technoroad/TR_DCDC_Module/README.md

# TR_DCDC_Module
TR製DCDCモジュール（ストロベリーリナックス製LT3790モジュールの代替品）
