technoroad/TR_DCDC_Module/TR_i3_6A_Module_v11/readme.txt

---------------------------------------------------------------

RS-274X File List

---------------------------------------------------------------
* Outline		TR_i3_6A_Module_v11.out
* Top Side		TR_i3_6A_Module_v11.cmp
* Bottom Side		TR_i3_6A_Module_v11.sol

* Top Silkscreen	TR_i3_6A_Module_v11.plc
* Bottom Silkscreen	TR_i3_6A_Module_v11.pls

* Top Soldermask	TR_i3_6A_Module_v11.stc
* Bottom Soldermask	TR_i3_6A_Module_v11.sts

* Top Metal Mask	TR_i3_6A_Module_v11.mmc
* Bottom Metal Mask	TR_i3_6A_Module_v11.mms

* Drill List		TR_i3_6A_Module_v11.drl
* Drill Data1		TR_i3_6A_Module_v11.drd
* Drill Data2		TR_i3_6A_Module_v11.dri

---------------------------------------------------------------
