technoroad/TR_DCDC_Module/TR_i3_6A_Module_v10/TR_i3_6A_Module_v10_ガーバー/readme.txt

---------------------------------------------------------------

RS-274X File List

---------------------------------------------------------------
* Outline		TR_i3_6A_Module_v10.out
* Top Side		TR_i3_6A_Module_v10.cmp
* Bottom Side		TR_i3_6A_Module_v10.sol

* Top Silkscreen	TR_i3_6A_Module_v10.plc
* Bottom Silkscreen	TR_i3_6A_Module_v10.pls

* Top Soldermask	TR_i3_6A_Module_v10.stc
* Bottom Soldermask	TR_i3_6A_Module_v10.sts

* Top Metal Mask	TR_i3_6A_Module_v10.mmc
* Bottom Metal Mask	TR_i3_6A_Module_v10.mms

* Drill List		TR_i3_6A_Module_v10.drl
* Drill Data1		TR_i3_6A_Module_v10.drd
* Drill Data2		TR_i3_6A_Module_v10.dri

---------------------------------------------------------------
