technoroad/TR_DCDC_Module/TR_i3_6A_Module_v5/ガーバー/readme.txt

---------------------------------------------------------------

RS-274X File List

---------------------------------------------------------------
* Outline		TR_i3_6A_Module_v5.out
* Top Side		TR_i3_6A_Module_v5.cmp
* Bottom Side		TR_i3_6A_Module_v5.sol

* Top Silkscreen	TR_i3_6A_Module_v5.plc
* Bottom Silkscreen	TR_i3_6A_Module_v5.pls

* Top Soldermask	TR_i3_6A_Module_v5.stc
* Bottom Soldermask	TR_i3_6A_Module_v5.sts

* Top Metal Mask	TR_i3_6A_Module_v5.mmc
* Bottom Metal Mask	TR_i3_6A_Module_v5.mms

* Drill List		TR_i3_6A_Module_v5.drl
* Drill Data		TR_i3_6A_Module_v5.drd

---------------------------------------------------------------
