technoroad/TR_DCDC_Module/TR_i3_6A_Module_v11/レジスト開口.png

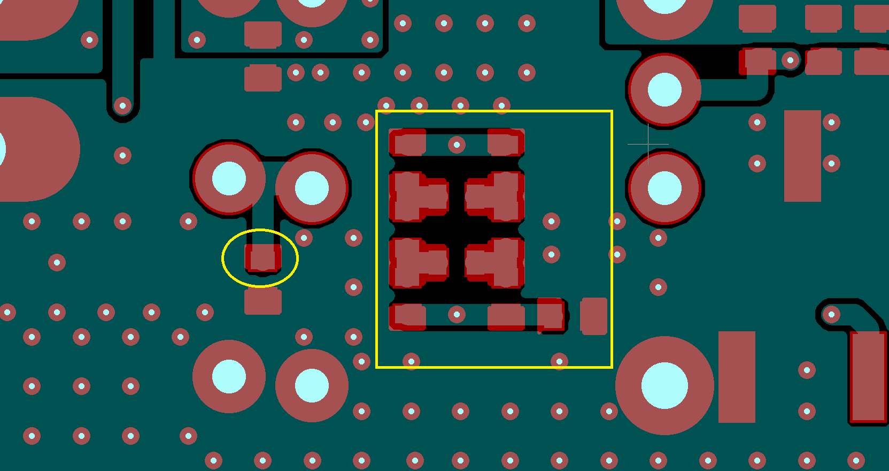
TR_i3_6A_Module_v11/レジスト開口.png
