technoroad/TR_DCDC_Module/TR_i3_6A_Module_部品リスト(TR製DCDCモジュール).xlsx

更新
2022-12-20
基板製造数
10 |  |  | TR製DCDCモジュール （ロボット電源）基板用_部品リスト
実装数
10
部品名 | シルク | 値 | 型番 | サイズ パッケージ | メーカー | 1基板 必要数 | 製造 必要 | 備考 | 購入先 | 最小購入数 または必要数 | 部品単価 | 小計 | URL | 基板単価 計算用
コンデンサ | C1, C2 | 0.1uF_100V | CS0603KRX7R0BB104 | 1.6 x 0.8 | Yageo | 2 | 20 |  | RS | 100 | 11.43 | 1143 | https://jp.rs-online.com/web/p/mlccs-multilayer-ceramic-capacitors/1988188 | 22.86
 | C3 | 1000pF_100V | GRM1882C2A102JA01D | 1.6 x 0.8 | Murata | 1 | 10 |  | RS | 100 | 3.98 | 398 | https://jp.rs-online.com/web/p/mlccs-multilayer-ceramic-capacitors/7984618 | 3.98
 | CC1, CC2 | 220uF_100V | 100PX220MEFC12.5X20 | 12.5 x 20 | Rubycon | 2 | 20 |  | Digikey | 50 | 106.42 | 5321 | https://www.digikey.jp/short/pvm9wfnq | 212.84
抵抗 | R1 | 別途 | 別途 | 1.6 x 0.8 | 別途 | 1 | 10 | 別途 | RS | 100 | 0 | 0 | 別途 | 0
 | R2 |  |  | 1.6 x 0.8 |  | 1 | 10 |  | RS | 100 | 0 | 0 |  | 0
 | R3 |  |  | 1.6 x 0.8 |  | 1 | 10 |  | RS | 100 | 0 | 0 |  | 0
 | R4 | Unused | Unused | 1.6 x 0.8 | Unused | 1 | 10 | Unused | RS | 100 | 0 | 0 | Unused | 0
 | R5 |  |  | 1.6 x 0.8 |  | 1 | 10 |  | RS | 100 | 0 | 0 |  | 0
 | R6 |  |  | 1.6 x 0.8 |  | 1 | 10 |  | RS | 100 | 0 | 0 |  | 0
 | R7 | 10k_5% | RC0603J10K | 1.6 x 0.8 | FAITHFUL LINK INDUSTRIAL CORP. | 1 | 10 | 在庫有り | RS | 5000 | 0.196 | 980 | https://akizukidenshi.com/catalog/g/gR-15029/ | 0.196
 | JP2, JP3, JP4, JP5, JP6 | 0 | RK73Z1JTTD | 1.6 x 0.8 | KOA | 5 | 50 | 在庫有り | 秋月 | 200 | 1 | 200 | https://akizukidenshi.com/catalog/g/gR-11619/ | 5
ジャンパー | JP1 | 2P | PH-1x40SG | 2P | Useconn Electronics Ltd. | 1 | 10 | 在庫有り | 秋月 | 40 | 0.875 | 35 | https://akizukidenshi.com/catalog/g/gC-00167/ | 0.875
DC-DCモジュール | IC1 | DC-DC | I3A4W008A033V-001-R | DIP | TDK | 1 | 10 | 在庫有り | Digikey | 15 | 2822 | 42330 | https://www.digikey.jp/short/vmwwvz22 | 2822
 | IC2 | DC-DC | I6A4W010A033V-001-R | DIP | TDK | 1 | 10 | 在庫有り | Digikey | 30 | 4165 | 124950 | https://www.digikey.jp/short/47jtdm2c | 4165
フォトリレー | IC3 | 350V, 0.11A | TLP172G | 11-5H1 | Toshiba | 1 | 10 |  | 秋月 | 25 | 140 | 3500 | https://akizukidenshi.com/catalog/g/gI-08687/ | 140
MOSFET | Q1 | Nch | BSS138 | SOT-23 | PANJIT INTERNATIONAL INC.(パンジット) | 1 | 10 | 在庫有り | 秋月 | 25 | 4 | 100 | https://akizukidenshi.com/catalog/g/gI-04232/
ショットキーバリアダイオード | D1 | ESD | SBM1060LSS | DIP | PANJIT INTERNATIONAL INC.(パンジット) | 1 | 10 |  | 秋月 | 10 | 10 | 100 | https://akizukidenshi.com/catalog/g/gI-16378/ | 10
定電流ダイオード | D2, D3 | 5.6mA_60V | S-562T | SMD | SEMITEC株式会社（石塚電子株式会社） | 2 | 20 |  | 秋月 | 5 | 40 | 200 | https://akizukidenshi.com/catalog/g/gI-06282/
LED | LED1 | Orange | OSOR1608C1A | 1.6 x 0.8 | OptoSupply | 1 | 10 | 在庫有り | 秋月 | 20 | 10 | 200 | https://akizukidenshi.com/catalog/g/gI-06416/
 | LED2 | Green | OSTG1608C1A | 1.6 x 0.8 | OptoSupply | 1 | 10 | 在庫有り | 秋月 | 20 | 12.5 | 250 | https://akizukidenshi.com/catalog/g/gI-06417/
NTCサーミスタ | NTC1 | 700mΩ_12A | SL22-0R712 | DIP | Ametherm | 1 | 10 |  | Digikey | 10 | 259.3 | 2593 | https://www.digikey.jp/short/hjjd5550
コネクタ | CN1 | VL-2P | B02P-VL (LF)(SN) | DIP | JST | 1 | 10 | 欠品 |  | 25 | 0 | 0 |  | 0
 | CN2 | VL-3P | B03P-VL (LF)(SN) | DIP | JST | 1 | 10 | 欠品 |  | 25 | 0 | 0 |  | 0
 | CN3 | XA-2P |  | DIP | JST | 1 | 10 | 在庫有り |  | 25 | 0 | 0
 | CN4 | EH-2P |  | DIP | JST | 1 | 10 | 在庫有り |  | 25 | 0 | 0 |  | 0
 |  |  |  |  |  |  |  |  |  |  | 合計 | 182300
 |  |  |  |  |  |  |  |  |  |  | 基板単価 | 7383
出力電圧設定抵抗
部品名 | シルク | 値 | 型番 | サイズ パッケージ | メーカー | 1基板 必要数 | 製造 必要 | 備考 | 購入先 | 最小購入数 または必要数 | 部品単価 | 小計 | URL | 基板単価 計算用
抵抗（i3A：5V） | R1 | 6.2k_1% | CRCW06036K20FKEA | 1.6 x 0.8 | Vishay | 1 | 10 |  | RS | 50 | 4.47 | 223.5 | https://jp.rs-online.com/web/p/surface-mount-resistors/6790664 | 4.47
 | R2 | 2.2k_1% | ERJPA3F2201V | 1.6 x 0.8 | Panasonic | 1 | 10 |  | RS | 100 | 6.08 | 608 | https://jp.rs-online.com/web/p/surface-mount-resistors/8626837 | 6.08
 | R3 | 180_1% | CRCW0603180RFKEA | 1.6 x 0.8 | Vishay | 1 | 10 |  | RS | 50 | 5.68 | 284 | https://jp.rs-online.com/web/p/surface-mount-resistors/6789841 | 5.68
 |  |  |  |  |  |  |  |  |  |  | 合計 | 1115.5
 |  |  |  |  |  |  |  |  |  |  | 基板単価 | 17
部品名 | シルク | 値 | 型番 | サイズ パッケージ | メーカー | 1基板 必要数 | 製造 必要 | 備考 | 購入先 | 最小購入数 または必要数 | 部品単価 | 小計 | URL | 基板単価 計算用
抵抗（i3A：6V） | R1 | 5.6k_1% | RK73H1JTTD5601F | 1.6 x 0.8 | KOA | 1 | 10 |  | RS | 50 | 4.2 | 210 | https://jp.rs-online.com/web/p/surface-mount-resistors/6316575 | 4.2
 | R2 | 300_1% | CR0603-FX-3000ELF | 1.6 x 0.8 | Bourns | 1 | 10 |  | RS | 50 | 4.53 | 226.5 | https://jp.rs-online.com/web/p/surface-mount-resistors/7408852 | 4.53
 | R3 | 10_1% | MCR03EZPFX10R0 | 1.6 x 0.8 | ローム | 1 | 10 |  | RS | 100 | 4.44 | 444 | https://jp.rs-online.com/web/p/surface-mount-resistors/9013516 | 4.44
 |  |  |  |  |  |  |  |  |  |  | 合計 | 880.5
 |  |  |  |  |  |  |  |  |  |  | 基板単価 | 14
部品名 | シルク | 値 | 型番 | サイズ パッケージ | メーカー | 1基板 必要数 | 製造 必要 | 備考 | 購入先 | 最小購入数 または必要数 | 部品単価 | 小計 | URL | 基板単価 計算用
抵抗（i3A：12V） | R1 | 1.8k_1% | CRCW06031K80FKEA | 1.6 x 0.8 | Vishay | 1 | 10 |  | RS | 50 | 6.09 | 304.5 | https://jp.rs-online.com/web/p/surface-mount-resistors/6789926 | 6.09
 | R2 | 20_1% | RC0603FR-0720RL | 1.6 x 0.8 | Yageo | 1 | 10 |  | RS | 100 | 1.36 | 136 | https://jp.rs-online.com/web/p/surface-mount-resistors/1995493 | 1.36
 |  |  |  |  |  |  |  |  |  |  | 合計 | 440.5
 |  |  |  |  |  |  |  |  |  |  | 基板単価 | 8
部品名 | シルク | 値 | 型番 | サイズ パッケージ | メーカー | 1基板 必要数 | 製造 必要 | 備考 | 購入先 | 最小購入数 または必要数 | 部品単価 | 小計 | URL | 基板単価 計算用
抵抗（i6A：19V） | R1 | 1k_1% | CRG0603F1K0 | 1.6 x 0.8 | TE Connectivity | 1 | 10 |  | RS | 50 | 4.75 | 237.5 | https://jp.rs-online.com/web/p/surface-mount-resistors/2132266 | 4.75
 | R2 | 62_1% | CRCW060362R0FKEA | 1.6 x 0.8 | Vishay | 1 | 10 |  | RS | 50 | 5.68 | 284 | https://jp.rs-online.com/web/p/surface-mount-resistors/6790617 | 5.68
 |  |  |  |  |  |  |  |  |  |  | 合計 | 521.5
 |  |  |  |  |  |  |  |  |  |  | 基板単価 | 11
部品名 | シルク | 値 | 型番 | サイズ パッケージ | メーカー | 1基板 必要数 | 製造 必要 | 備考 | 購入先 | 最小購入数 または必要数 | 部品単価 | 小計 | URL | 基板単価 計算用
抵抗（i6A：20V） | R1 | 7.5k_1% | CRCW06037K50FKEA | 1.6 x 0.8 | Vishay | 1 | 10 |  | RS | 50 | 5.68 | 284 | https://jp.rs-online.com/web/p/surface-mount-resistors/6790702 | 5.68
 | R2 | 2.2k_1% | ERJPA3F2201V | 1.6 x 0.8 | Panasonic | 1 | 10 |  | RS | 100 | 6.08 | 608 | https://jp.rs-online.com/web/p/surface-mount-resistors/8626837 | 6.08
 |  |  |  |  |  |  |  |  |  |  | 合計 | 892
 |  |  |  |  |  |  |  |  |  |  | 基板単価 | 12
