technoroad/TR_DCDC_Module/TR_i3_6A_Module_v11/TR_i3_6A_Module_v11_back.pdf

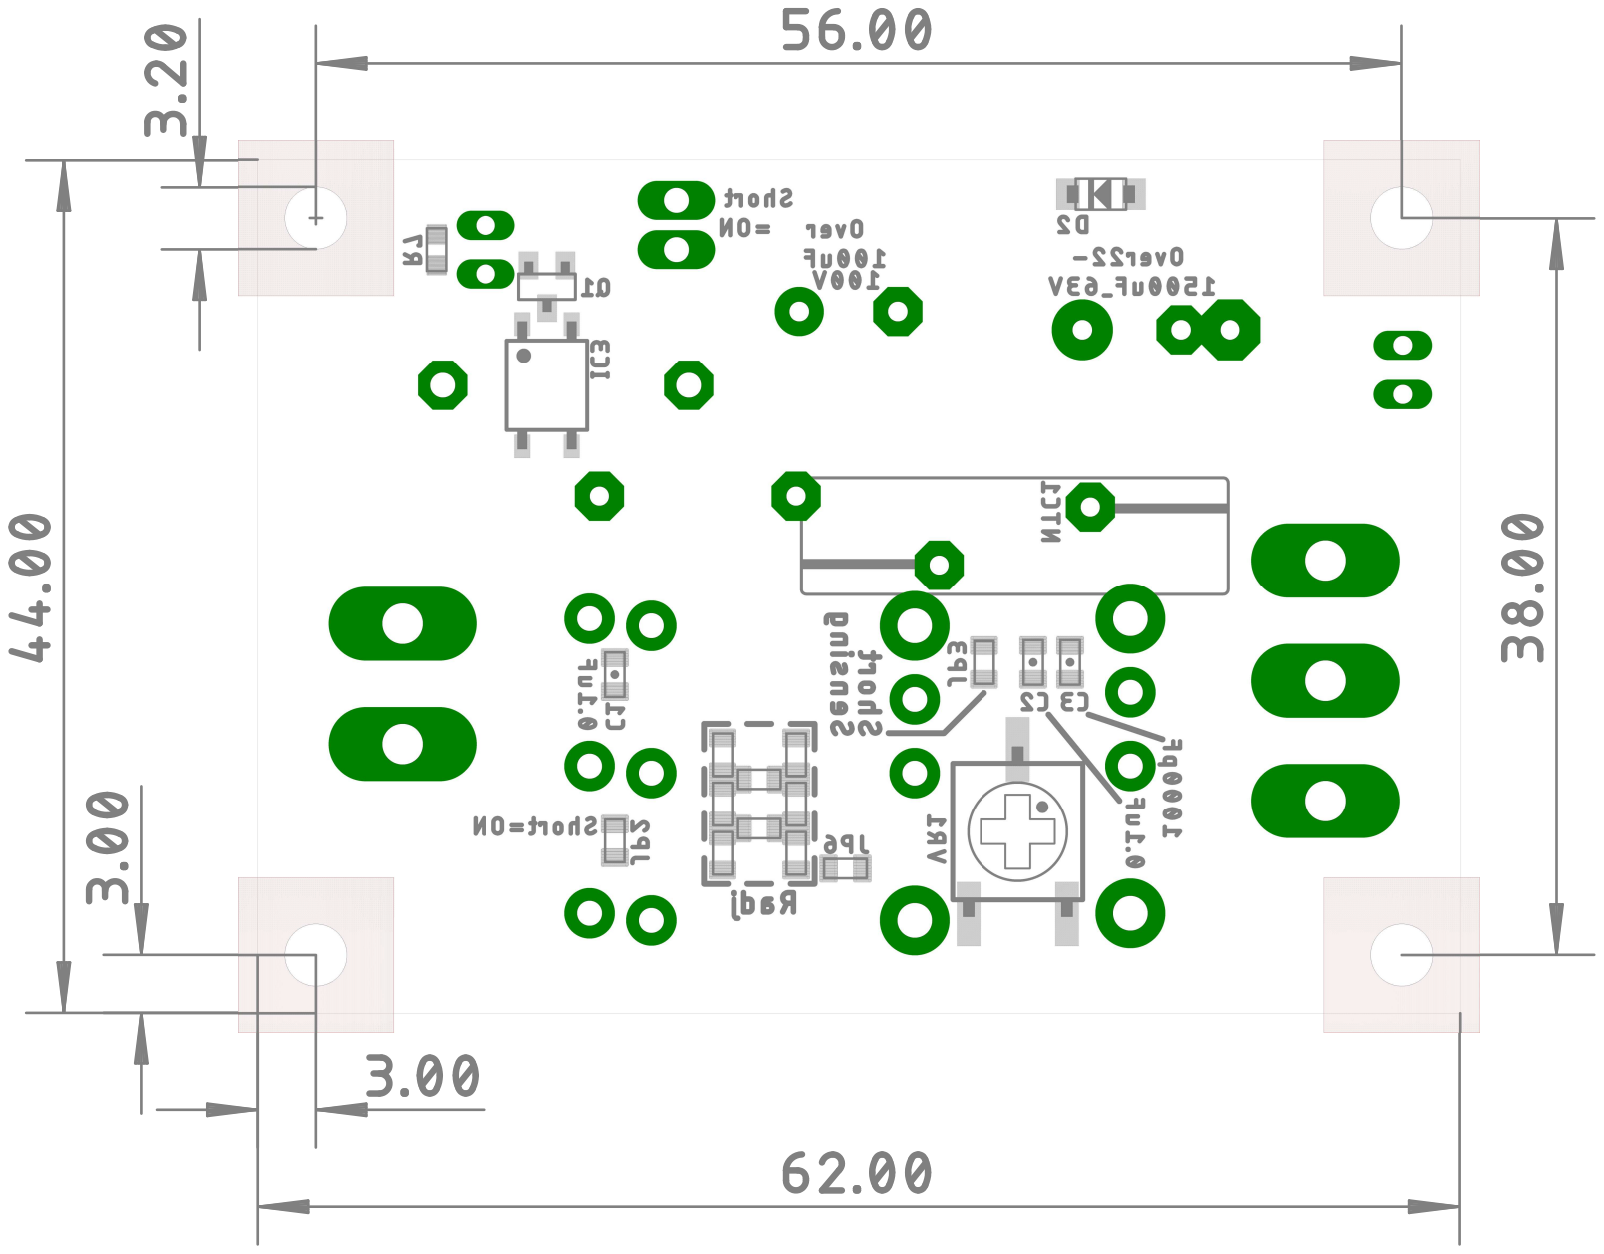
[picture p2: page 1]
