technoroad/TR_DCDC_Module/TR_i3_6A_Module_v11/TR_i3_6A_Module_v11.brd

## EAGLE design TR_i3_6A_Module_v11/TR_i3_6A_Module_v11.brd (2022-12-20)

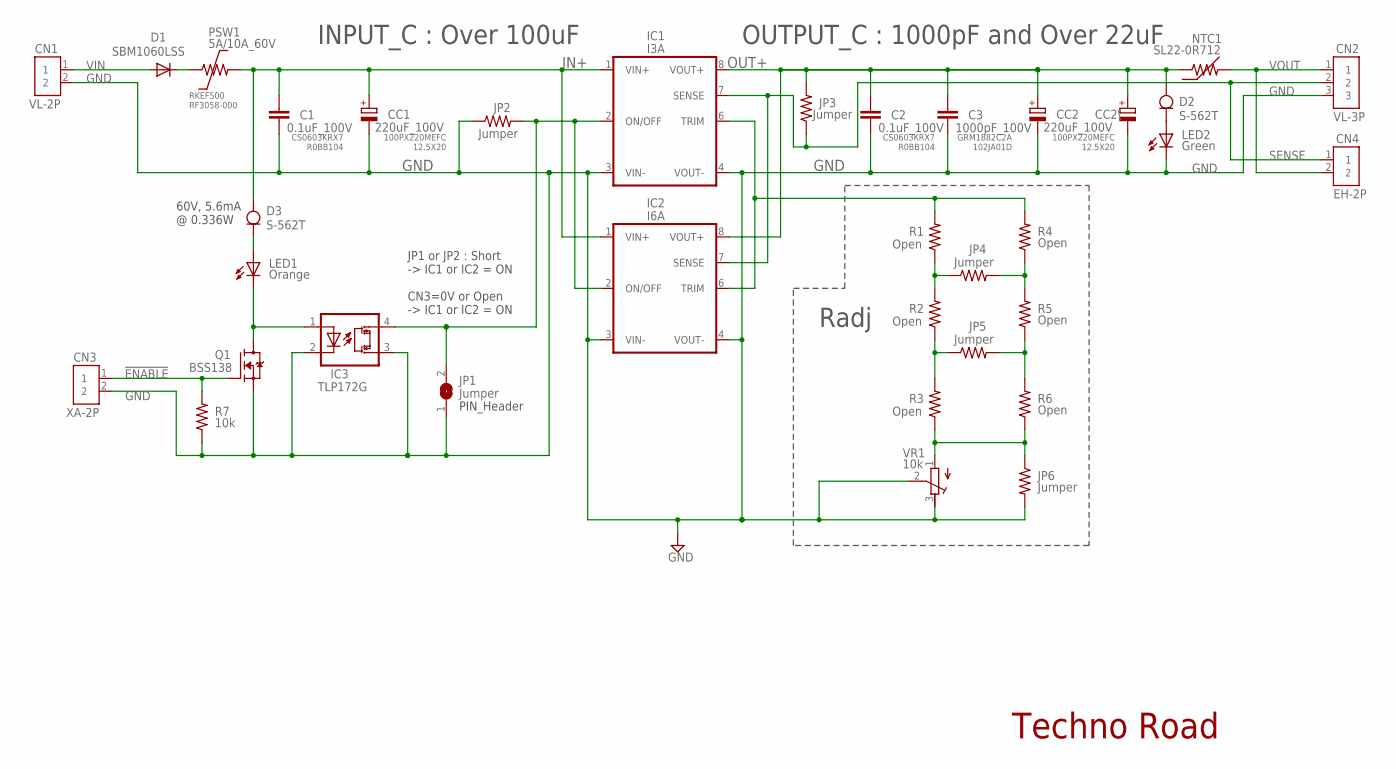
[picture p4: schematic TR_i3_6A_Module_v11.sch, sheet 1]

Parts:
C1, C2: 0.1uF_100V; C1608
C3: 1000pF_100V; C1608
CC1, CC2: 220uF_100V; CC0510
CC2\: CPOL-EUE7.5-16; E7,5-16
CN1: VL-2P; VL3-2P
CN2: VL-3P; VL3-3P
CN3: XA-2P; XA-2P_NH
CN4: EH-2P
D1: SBM1060LSS; 12.7MM
D2, D3: S-562T; S-XXXT
IC1: I3A; I3A_SERIES
IC2: I6A; I6A_SERIES
IC3: TLP172G; 11-5H1
JP1: Jumper; JP1D_HOLE
JP2, JP3, JP4, JP5, JP6: Jumper; R1608_LARGE_PAD
LED1: Orange; SML1608
LED2: Green; SML1608
NTC1: SL22-0R712; SL22
PSW1: 5A/10A_60V; PSW-10.16MM_4MM
Q1: BSS138; SOT-23-3
R1, R2, R3, R4, R5, R6: Open; R1608_LARGE_PAD
R7: 10k; R1608_LARGE_PAD
VR1: 10k; 3361P

Connections:
!ENABLE: CN3.1, Q1.1 (G), R7.2
D_PSW: D1.2 (C), PSW1.1
GND: C1.2, C2.2, C3.2, CC1.-, CC2.-, CC2\.-, CN1.2, CN2.3, CN3.2, IC1.3 (VIN-), IC1.4 (VOUT-), IC2.3 (VIN-), IC2.4 (VOUT-), IC3.2 (C1), IC3.3 (DRN1), JP1.1, JP2.1, JP6.2, LED2.C, Q1.2 (S), R7.1, VR1.2 (S), VR1.3 (E)
IN+: C1.1, CC1.+, D3.A, IC1.1 (VIN+), IC2.1 (VIN+), PSW1.2
unnamed: JP6.1, R3.1, R6.1, VR1.1 (A)
unnamed: JP4.1, R1.1, R2.2
unnamed: JP5.1, R2.1, R3.2
unnamed: IC1.2 (ON/OFF), IC2.2 (ON/OFF), IC3.4 (DRN2), JP1.2, JP2.2
unnamed: D2.C, LED2.A
unnamed: D3.C, LED1.A
unnamed: IC1.6 (TRIM), IC2.6 (TRIM), R1.2, R4.2
unnamed: JP4.2, R4.1, R5.2
unnamed: JP5.2, R5.1, R6.2
unnamed: IC3.1 (A1), LED1.C, Q1.3 (D)
OUT+: C2.1, C3.1, CC2.+, CC2\.+, D2.A, IC1.8 (VOUT+), IC2.8 (VOUT+), JP3.2, NTC1.1
SENSE: CN2.2, CN4.1, IC1.7 (SENSE), IC2.7 (SENSE), JP3.1
VIN: CN1.1, D1.1 (A)
VOUT: CN2.1, CN4.2, NTC1.2

Notes on the sheet:
OUTPUT_C : 1000pF and Over 22uF
INPUT_C : Over 100uF
Techno Road
Radj
JP1 or JP2 : Short -> IC1 or IC2 = ON CN3=0V or Open -> IC1 or IC2 = ON
100PX220MEFC 12.5X20
CS0603KRX7 R0BB104
GRM1882C2A 102JA01D
PIN_Header
60V, 5.6mA @ 0.336W
RKEF500 RF3058-000

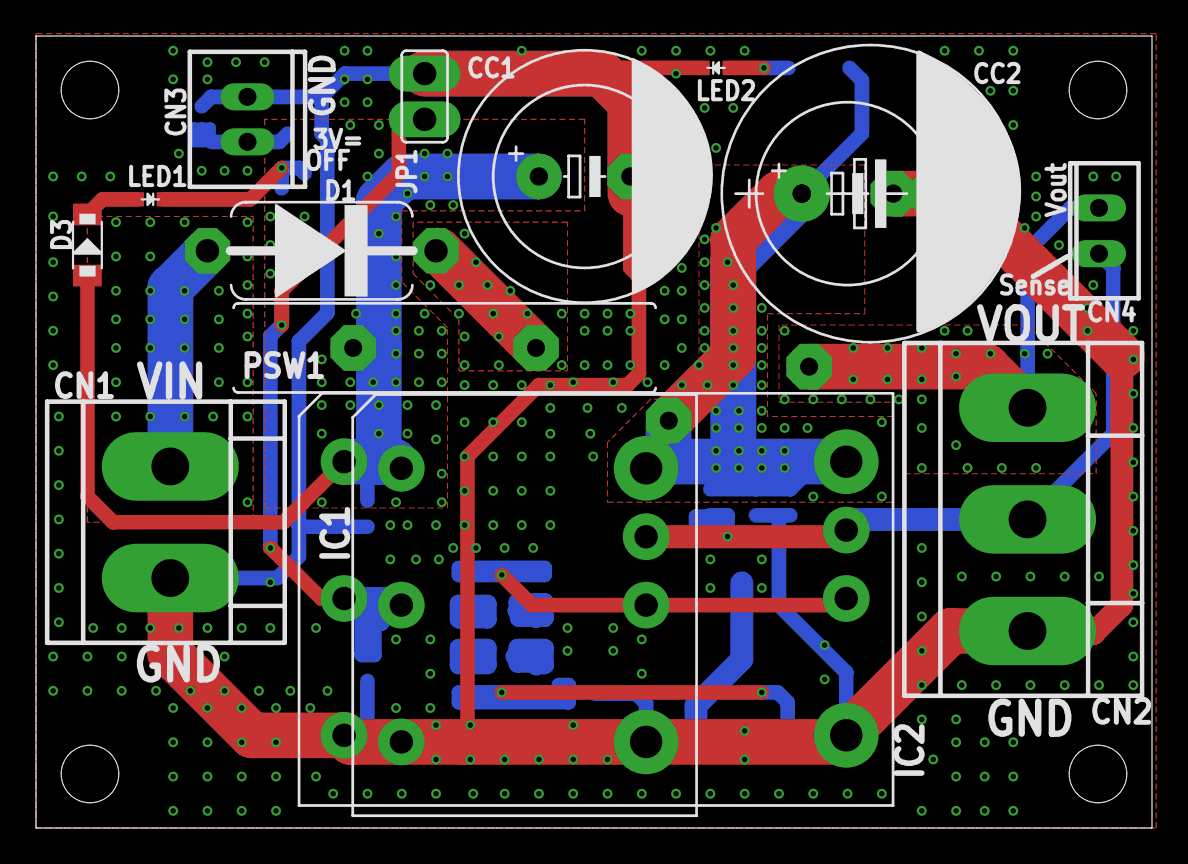
[picture p5: board TR_i3_6A_Module_v11.brd from above]

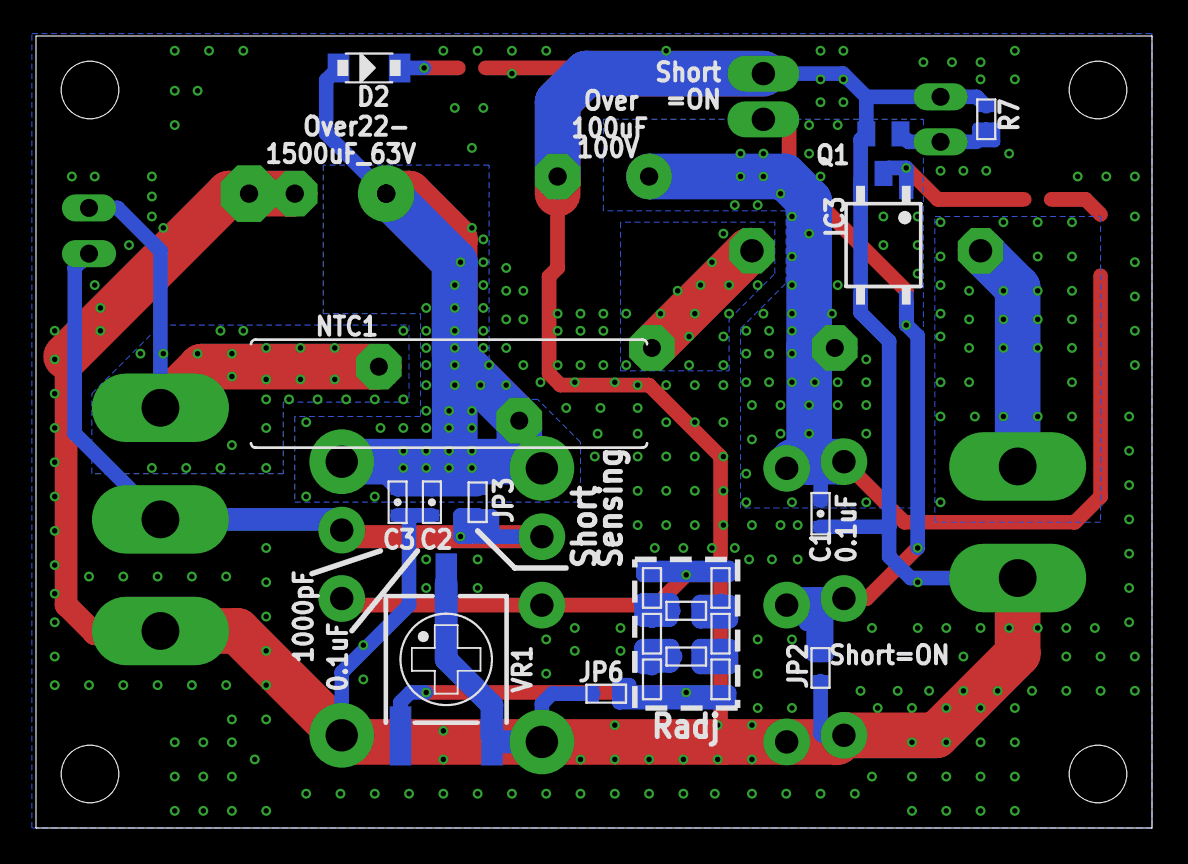
[picture p6: board TR_i3_6A_Module_v11.brd from below]

Board: 2 copper layers, 62.0 x 44.0 mm, 35 parts (20 on the bottom side), 18 nets.
