technoroad/TR_DCDC_Module/TR_i3_6A_Module_v5/TR_i3_6A_Module_v5.brd

## EAGLE design TR_i3_6A_Module_v5/TR_i3_6A_Module_v5.brd (2022-10-03, an earlier design)

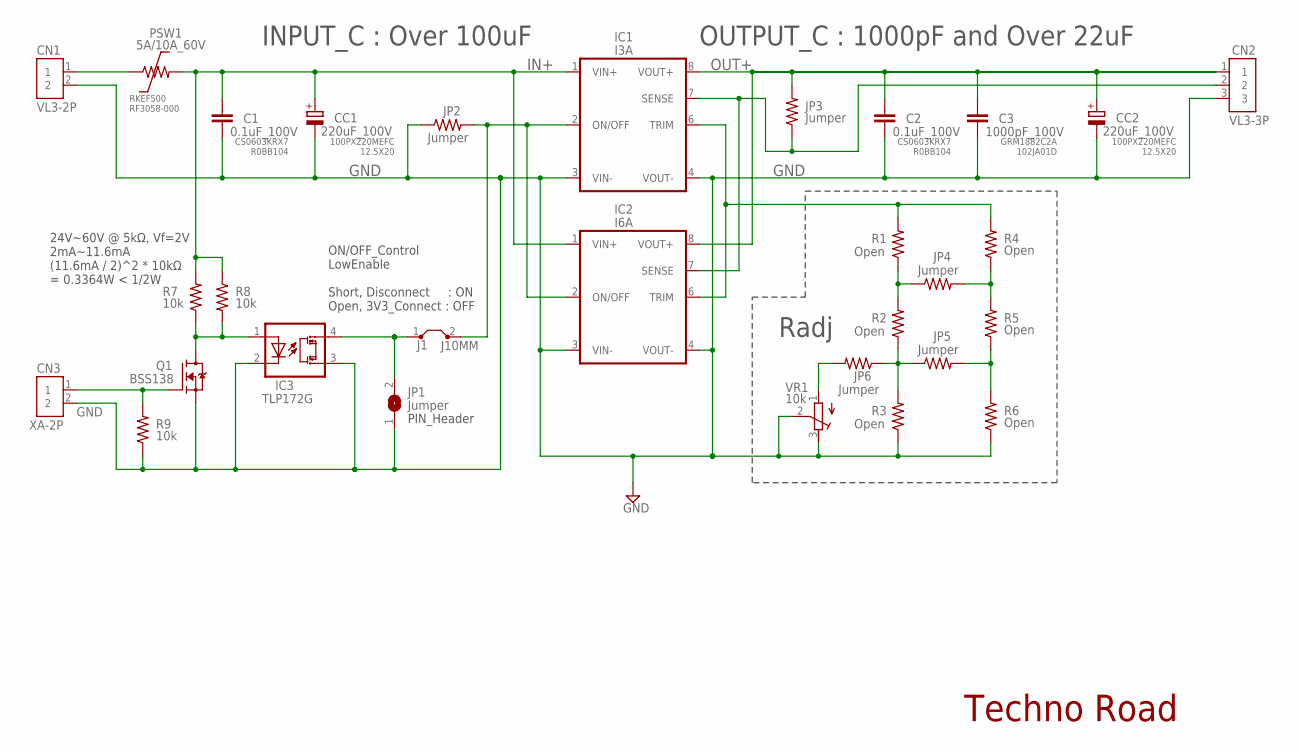
[picture p7: schematic TR_i3_6A_Module_v5.sch]

Parts:
C1, C2: 0.1uF_100V; C1608
C3: 1000pF_100V; C1608
CC1, CC2: 220uF_100V; CC0510
CN1: VL3-2P
CN2: VL3-3P
CN3: XA-2P; XA-2P_NH
IC1: I3A; I3A_SERIES
IC2: I6A; I6A_SERIES
IC3: TLP172G; 11-5H1
J1: J10MM; 10
JP1: Jumper; JP1D_HOLE
JP2, JP3, JP4, JP5, JP6: Jumper; R1608_LARGE_PAD
PSW1: 5A/10A_60V; PSW-10.16MM_4MM
Q1: BSS138; SOT-23-3
R1, R2, R3, R4, R5, R6: Open; R1608_LARGE_PAD
R7, R8: 10k; 0204V
R9: 10k; R1608_LARGE_PAD
VR1: 10k; 3361P

Connections:
GND: C1.2, C2.2, C3.2, CC1.-, CC2.-, CN1.2, CN2.3, CN3.2, IC1.3 (VIN-), IC1.4 (VOUT-), IC2.3 (VIN-), IC2.4 (VOUT-), IC3.2 (C1), IC3.3 (DRN1), JP1.1, JP2.1, Q1.2 (S), R3.1, R6.1, R9.1, VR1.2 (S), VR1.3 (E)
IN+: C1.1, CC1.+, IC1.1 (VIN+), IC2.1 (VIN+), PSW1.2, R7.2, R8.1
unnamed: JP4.1, R1.1, R2.2
unnamed: JP5.1, JP6.1, R2.1, R3.2
unnamed: IC3.4 (DRN2), J1.1, JP1.2
unnamed: CN2.2, IC1.7 (SENSE), IC2.7 (SENSE), JP3.1
unnamed: IC1.2 (ON/OFF), IC2.2 (ON/OFF), J1.2, JP2.2
unnamed: IC1.6 (TRIM), IC2.6 (TRIM), R1.2, R4.2
unnamed: JP4.2, R4.1, R5.2
unnamed: JP5.2, R5.1, R6.2
unnamed: IC3.1 (A1), Q1.3 (D), R7.1, R8.2
unnamed: CN1.1, PSW1.1
unnamed: JP6.2, VR1.1 (A)
unnamed: CN3.1, Q1.1 (G), R9.2
OUT+: C2.1, C3.1, CC2.+, CN2.1, IC1.8 (VOUT+), IC2.8 (VOUT+), JP3.2

Notes on the sheet:
OUTPUT_C : 1000pF and Over 22uF
INPUT_C : Over 100uF
Techno Road
Radj
ON/OFF_Control LowEnable Short, Disconnect : ON Open, 3V3_Connect : OFF
100PX220MEFC 12.5X20
CS0603KRX7 R0BB104
GRM1882C2A 102JA01D
PIN_Header
24V~60V @ 5kΩ, Vf=2V 2mA~11.6mA (11.6mA / 2)^2 * 10kΩ = 0.3364W < 1/2W
RKEF500 RF3058-000

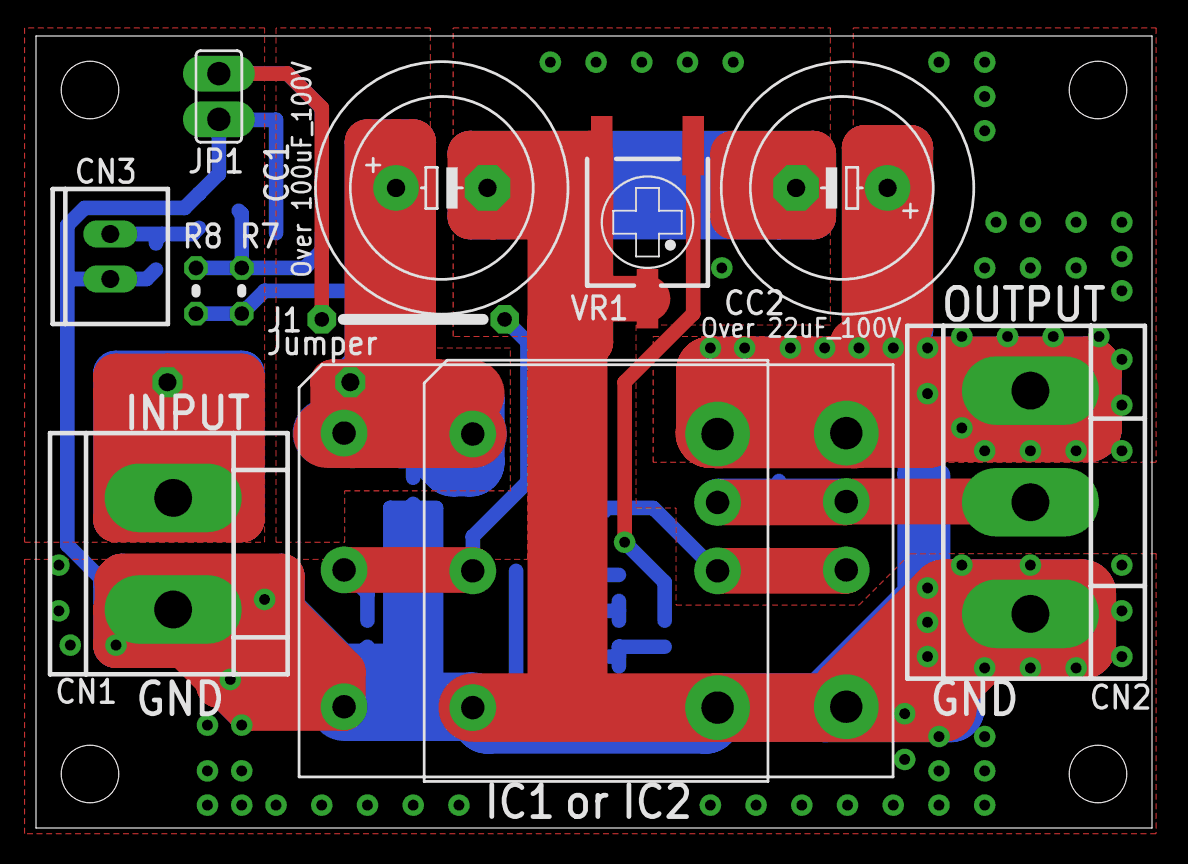
[picture p8: board TR_i3_6A_Module_v5.brd from above]

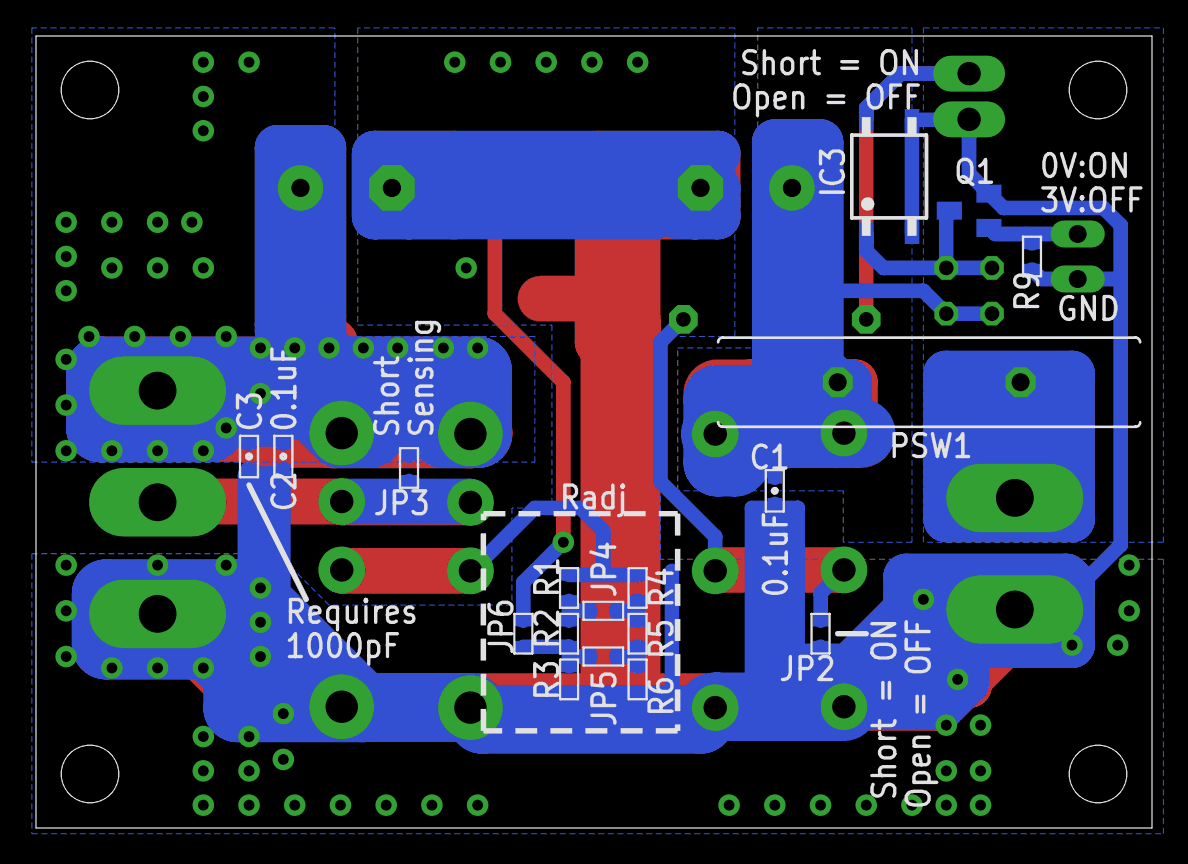
[picture p9: board TR_i3_6A_Module_v5.brd from below]

Board: 2 copper layers, 62.0 x 44.0 mm, 30 parts (18 on the bottom side), 15 nets.
