technoroad/TR_DCDC_Module/(commit log)

2022-10-03 ストロベリーリナックスのLT3970モジュールの代替品
    5Gロボット以前（5Gロボット含む）で使用
    [TR_i3_6A_Module_v5.brd, TR_i3_6A_Module_v5.sch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]
2022-10-03 Revert "ストロベリーリナックスのLT3790モジュールの代替品"
    This reverts commit fc3d5e599f8793499d1b9bfd4d8ecacdd8420709.
    [TR_i3_6A_Module_v5.brd, TR_i3_6A_Module_v5.sch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]
2022-10-03 TR製DCDCモジュール（ストロベリーリナックスのLT3790モジュールの代替品）
    5Gロボット以前（5Gロボット含む）に使用のTR製DCDCモジュール
    [TR_i3_6A_Module_v5.brd, TR_i3_6A_Module_v5.sch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]
2022-10-04 TR製DCDCモジュール（ストロベリーリナックスのLT3790モジュールの代替品）
    5Gロボットより後に使用予定の“新”TR製DCDCモジュール
    [TR_i3_6A_Module_v10.brd, TR_i3_6A_Module_v10.sch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]
2022-12-15 TR製DCDCモジュール（ストロベリーリナックスのLT3790モジュールの代替品）
    v10の基板のコネクタを元に戻し、はんだ盛り部分を無くしたもの。
    [TR_i3_6A_Module_v11.brd, TR_i3_6A_Module_v11.sch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]
2022-12-16 TR製DCDCモジュール（ストロベリーリナックスのLT3790モジュールの代替品）
    レイアウト修正
    [TR_i3_6A_Module_v11.brd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]
2022-12-19 TR製DCDCモジュール（ストロベリーリナックスのLT3790モジュールの代替品）
    レイアウト・ビア修正
    [TR_i3_6A_Module_v11.brd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]
2022-12-20 TR製DCDCモジュール（ストロベリーリナックスのLT3790モジュールの代替品）
    部品表、計算表追加
    [TR_i3_6A_Module_部品リスト(TR製DCDCモジュール).xlsx, i3A_i6A_Series_Calc_20221220.xlsx]
2022-12-20 TR製DCDCモジュール（ストロベリーリナックスのLT3790モジュールの代替品）
    基板データ更新
    [TR_i3_6A_Module_v11.brd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]
2022-12-20 TR製DCDCモジュール（ストロベリーリナックスのLT3790モジュールの代替品）
    レジスト開口部の修正。（指摘画像あり）
    [TR_i3_6A_Module_v11.brd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]
